wzy810103882/Vacant-Seat-Detector-System/Capstone Resource/CC3200 PCB/Headerboard concept.JPG

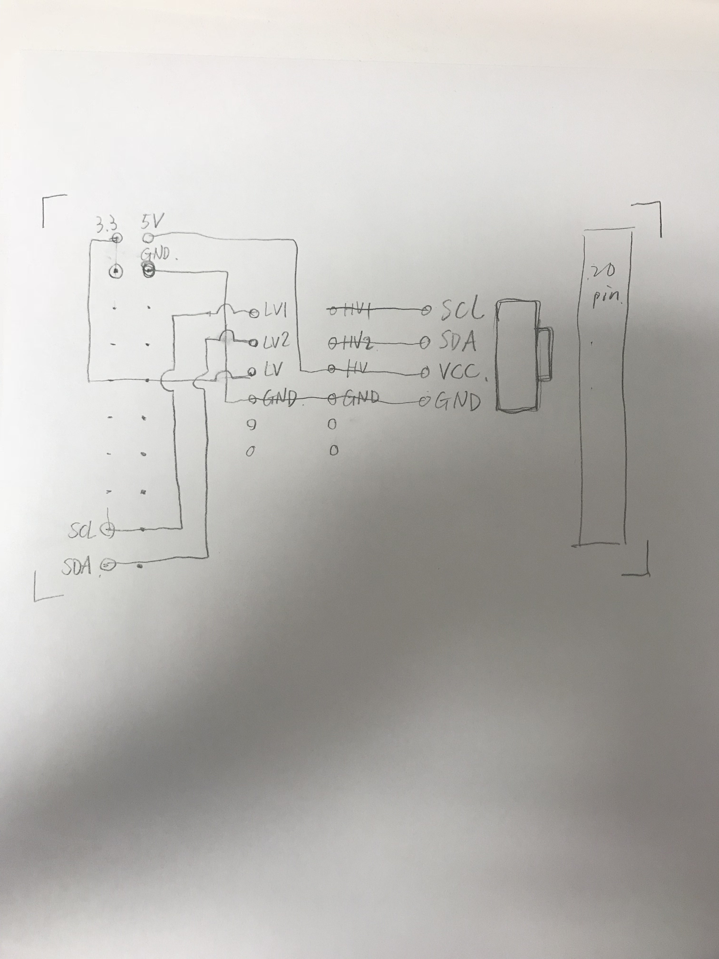
Capstone Resource/CC3200 PCB/Headerboard concept.JPG
