wzy810103882/Vacant-Seat-Detector-System/Capstone Resource/INFO/Screen Shot 2017-11-08 at 17.58.53.png

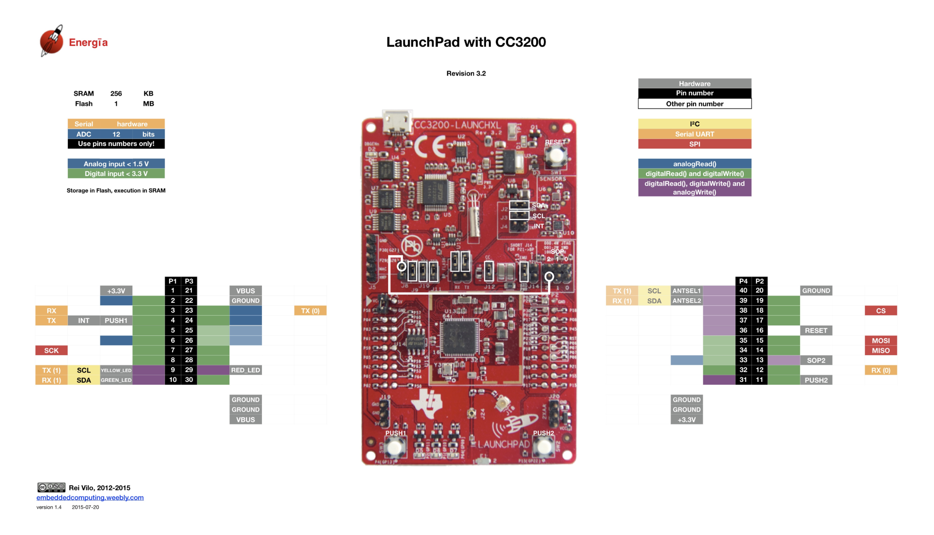
Capstone Resource/INFO/Screen Shot 2017-11-08 at 17.58.53.png
