wzy810103882/Vacant-Seat-Detector-System/Readme.txt

Track changes were turned after exporting from Google Doc
