wzy810103882/Vacant-Seat-Detector-System/Capstone Resource/CC3200 headerboard first sendout/s1.pdf

Job:0026870504903523+dfm.fdfm732002 Step:quote Layer:s1

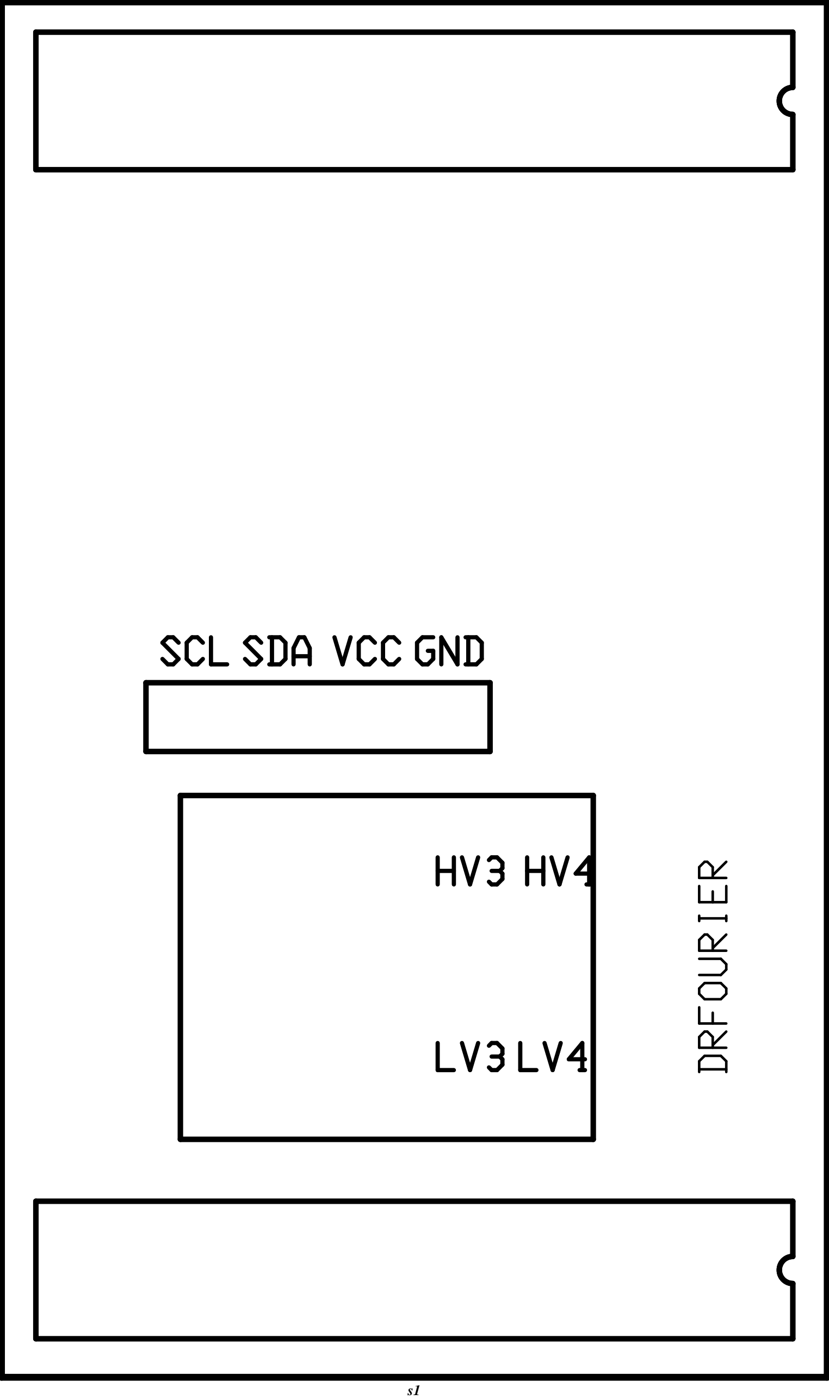
[picture p30: figure]
