wzy810103882/Vacant-Seat-Detector-System/Capstone Resource/cc3200 dimension.png

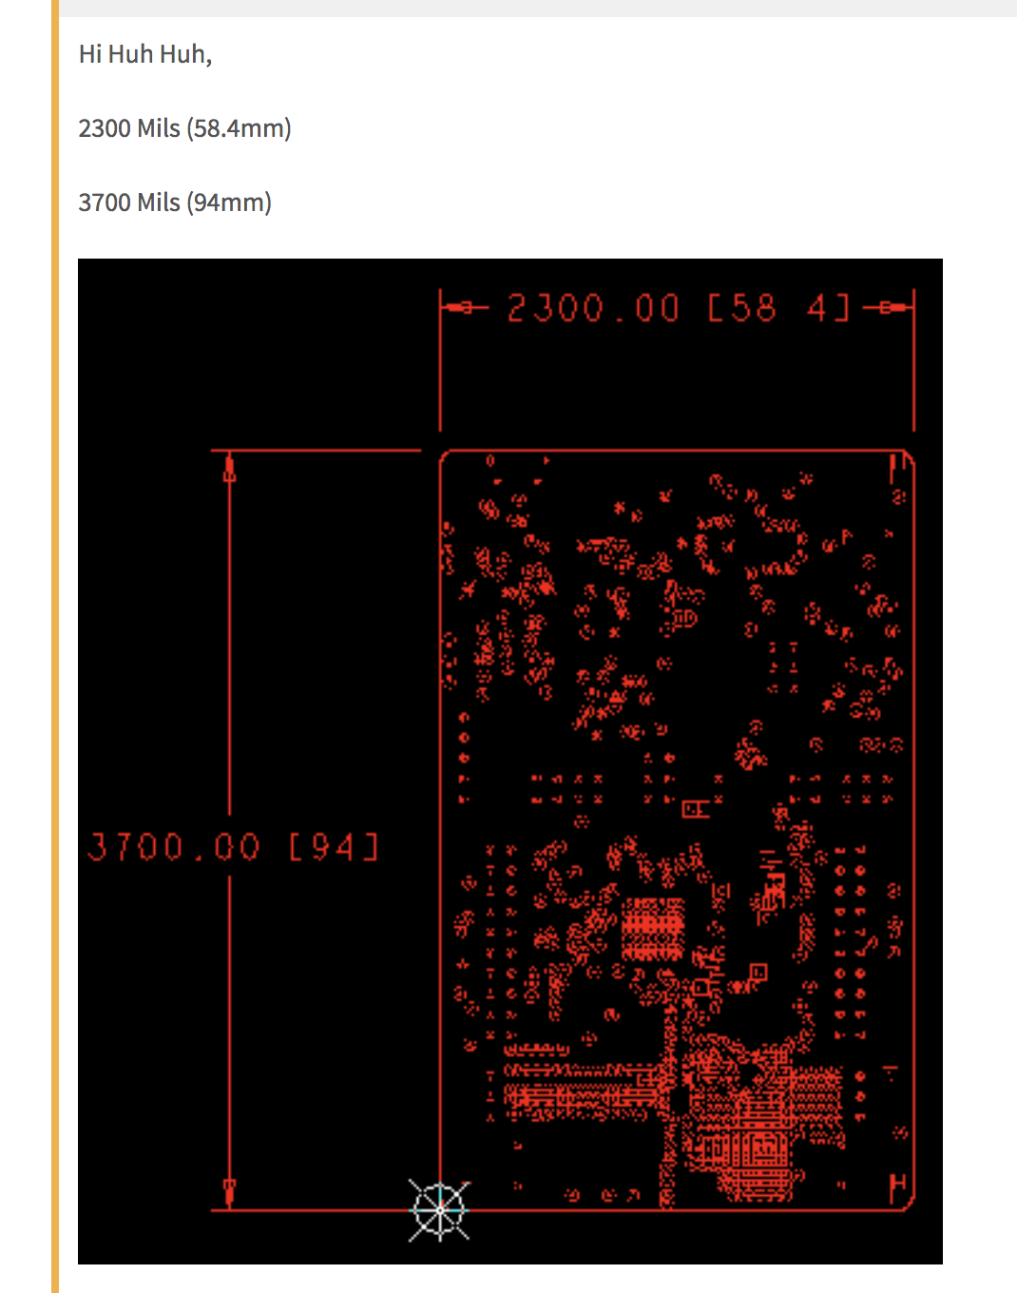
Capstone Resource/cc3200 dimension.png
