wzy810103882/Vacant-Seat-Detector-System/Capstone Resource/INFO/Screen Shot 2017-11-08 at 10.18.11.png

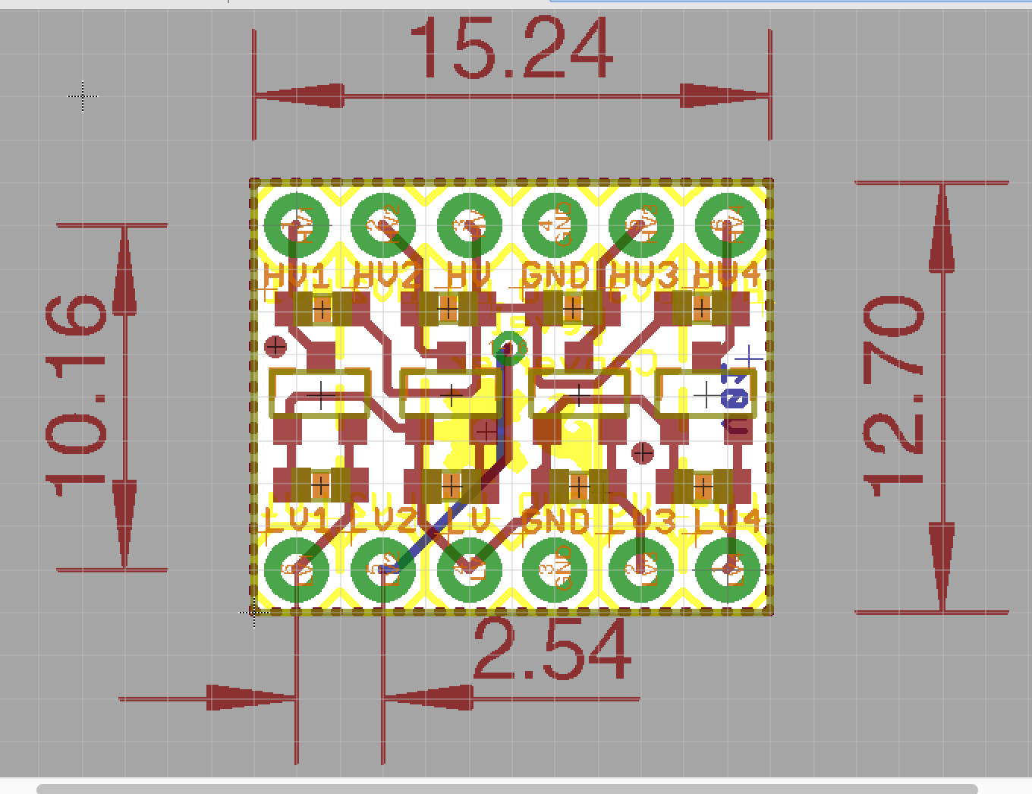
Capstone Resource/INFO/Screen Shot 2017-11-08 at 10.18.11.png
