wzy810103882/Vacant-Seat-Detector-System/Capstone Resource/INFO/Screen Shot 2017-11-10 at 10.47.15.png

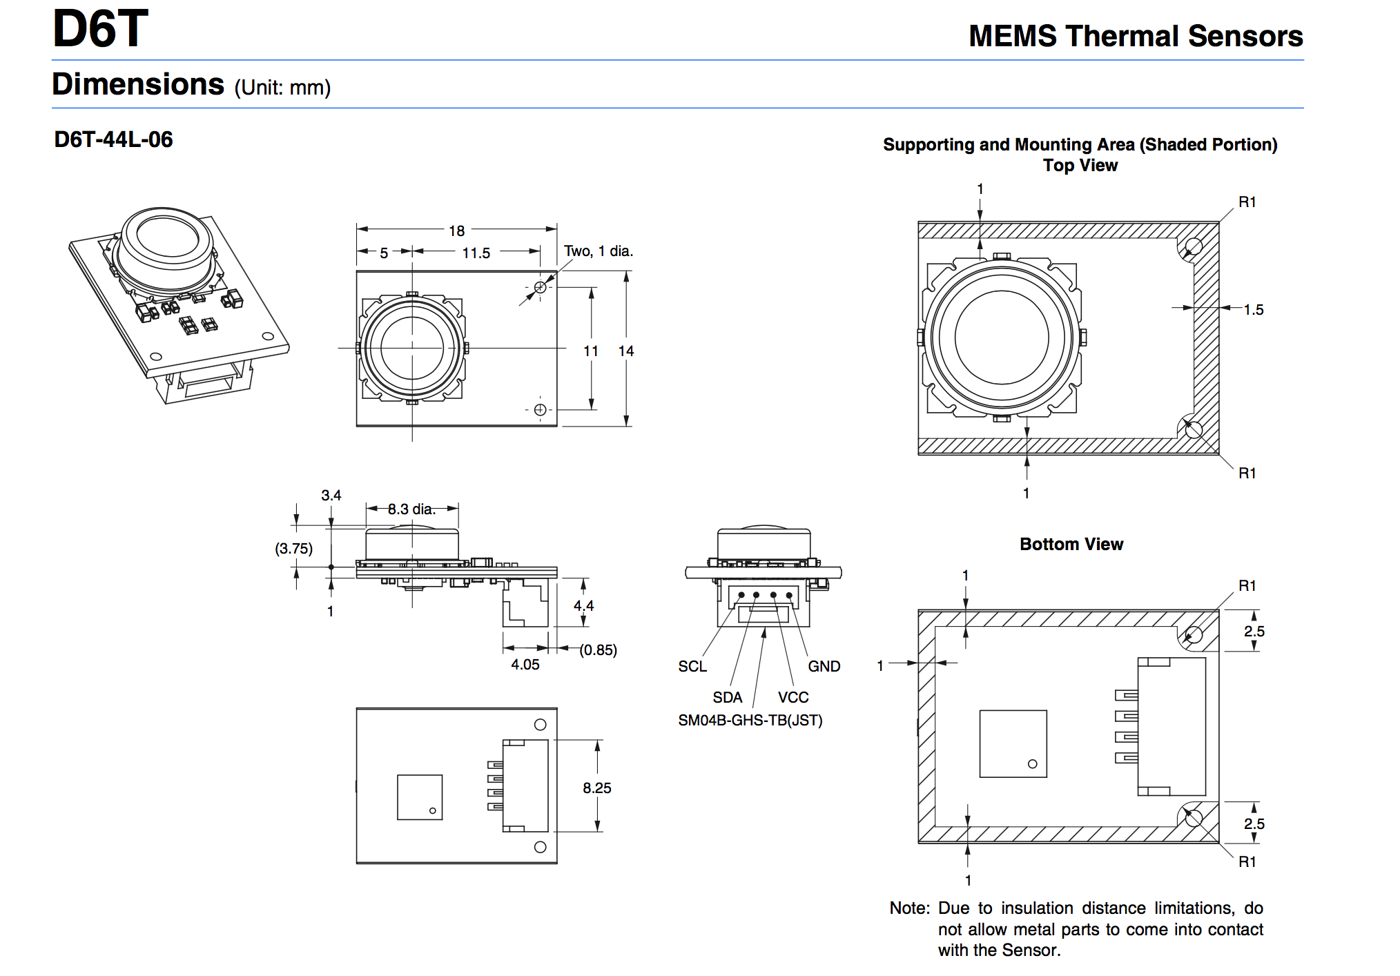
Capstone Resource/INFO/Screen Shot 2017-11-10 at 10.47.15.png
