wzy810103882/Vacant-Seat-Detector-System/Capstone Resource/Part Ordered/Dr. Fourier Parts.xlsx

 | Price per unit | number of units | total unit cost | part number | Link | Distributor | Datasheet
D6T Sensor | 52.5 | 1 | 52.5 | Z3637-ND | https://www.digikey.com/product-detail/en/omron-electronics-inc-emc-div/D6T44L06/Z3637-ND/3671589 | Digikey | From link
CC3100 Module | 20.76 | 1 | 20.76 | 296-37769-ND | https://www.digikey.com/product-detail/en/texas-instruments/CC3100BOOST/296-37769-ND/4862810 | Digikey | From link
