wzy810103882/Vacant-Seat-Detector-System/Capstone Resource/Part Ordered/Dr. Fourier Parts2.xlsx

 | Price per unit | number of units | total unit cost | part number | Link | Distributor | Datasheet
2-Way Logic Shifter | 2.95 | 1 | 2.95 | 1568-1209-ND | https://www.digikey.com/scripts/DkSearch/dksus.dll?Detail&itemSeq=241314373&uq=636438559609488572 | Digikey | From link
