wzy810103882/Vacant-Seat-Detector-System/Capstone Resource/Part Ordered/Dr. Fourier Parts3.xlsx

 | Price per unit | number of units | total unit cost | part number | Link | Distributor | Datasheet
CONN HEADER FEM 20POS.1" DL GOLD | 1.26 | 4 | 5.04 | S6106-ND | https://www.digikey.com/products/en?mpart=PPPC102LFBN-RC&v=35 | Digikey | From link
