wzy810103882/Vacant-Seat-Detector-System/Capstone Resource/final cad/beam.stl

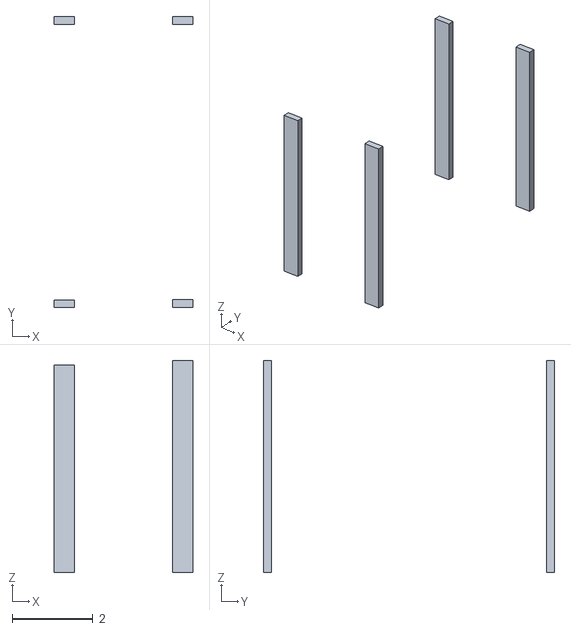
[picture p36: CAD file, 2018-04-12]
Capstone Resource/final cad/beam.stl
3.43 x 7.21 x 5.25
