wzy810103882/Vacant-Seat-Detector-System/Capstone Resource/Case/beam_2.stl

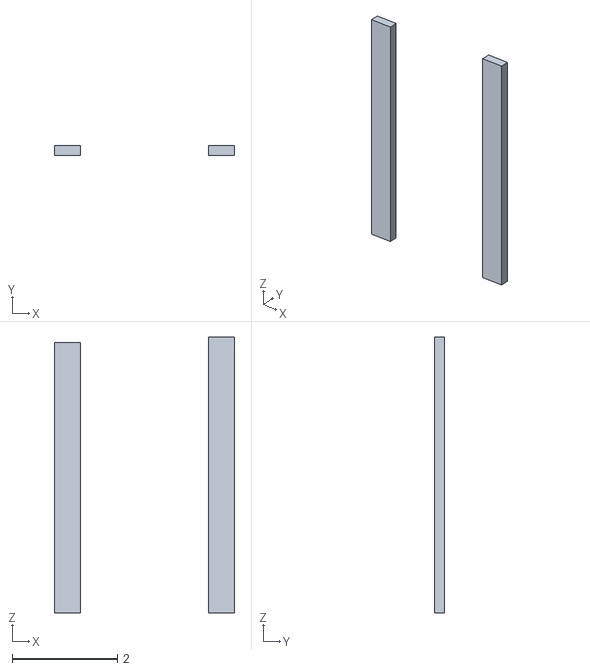
[picture p37: CAD file, 2018-04-12]
Capstone Resource/Case/beam_2.stl
3.43 x 0.198 x 5.25
