wzy810103882/Vacant-Seat-Detector-System/Capstone Resource/Case1/case_small_cubepro.stl

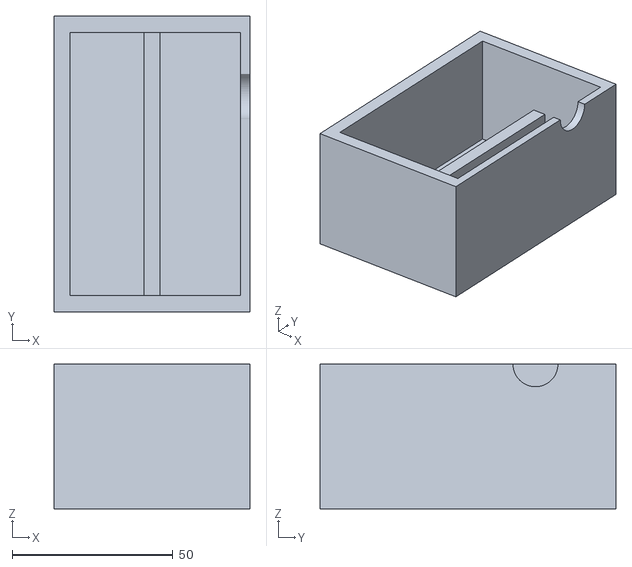
[picture p38: CAD file, 2018-04-12]
Capstone Resource/Case1/case_small_cubepro.stl
61.0 x 92.0 x 45.0
