wzy810103882/Vacant-Seat-Detector-System/Capstone Resource/final cad/Case_small_slot.stl

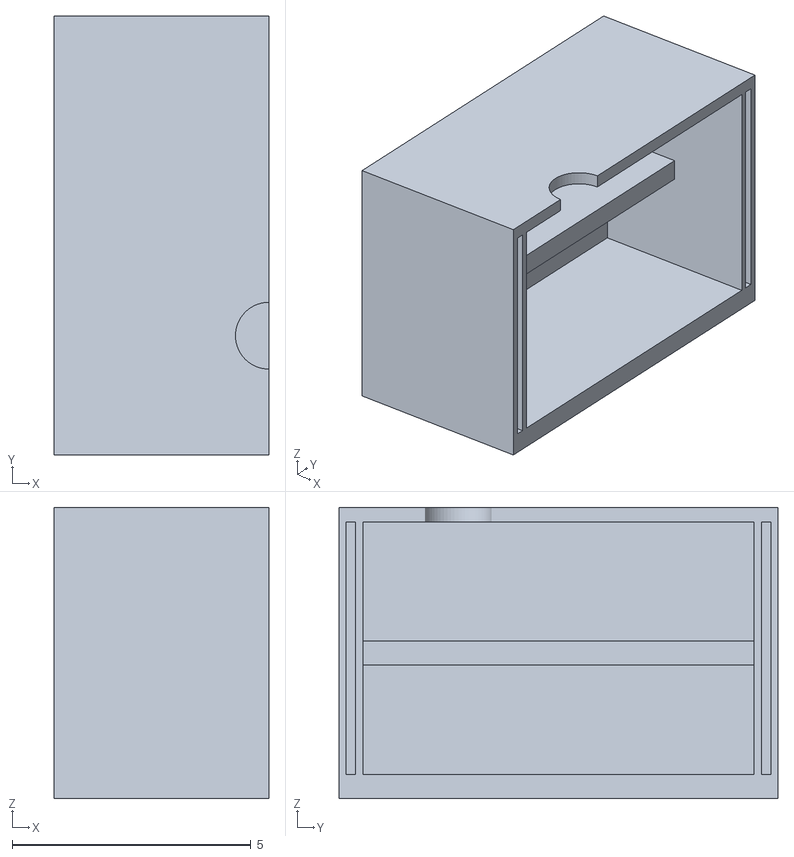
[picture p39: CAD file, 2018-04-12]
Capstone Resource/final cad/Case_small_slot.stl
4.50 x 9.20 x 6.10
