wzy810103882/Vacant-Seat-Detector-System/Capstone Resource/Case/Capstone Case.stl

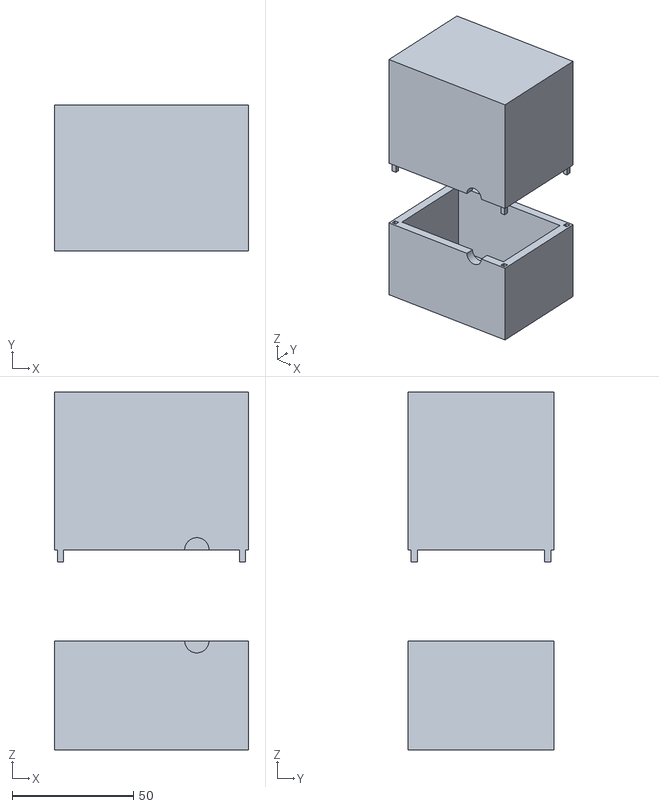
[picture p40: CAD file, 2018-04-12]
Capstone Resource/Case/Capstone Case.stl
80.0 x 60.0 x 147.5
