wzy810103882/Vacant-Seat-Detector-System/Capstone Resource/Case1/case_small.stl

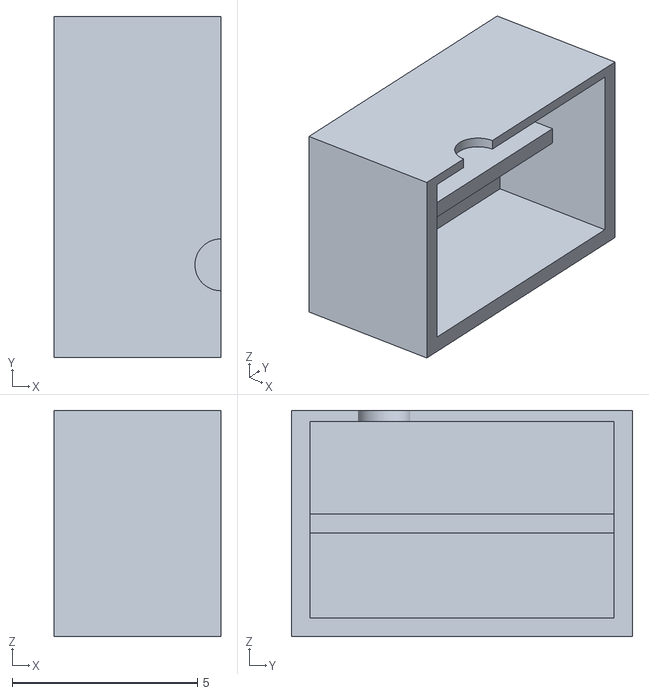
[picture p41: CAD file, 2018-04-12]
Capstone Resource/Case1/case_small.stl
4.50 x 9.20 x 6.10
