wzy810103882/Vacant-Seat-Detector-System/Capstone Resource/final cad/Case_large.stl

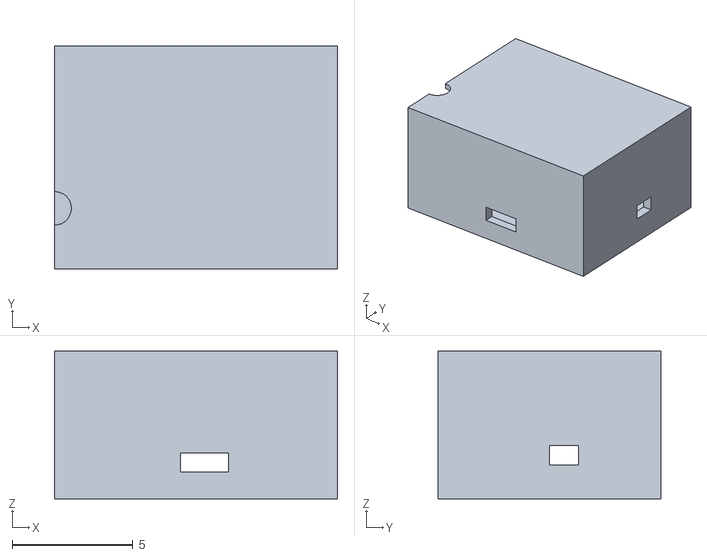
[picture p42: CAD file, 2018-04-12]
Capstone Resource/final cad/Case_large.stl
11.7 x 9.20 x 6.10
