wzy810103882/Vacant-Seat-Detector-System/Capstone Resource/Case1/Case_forprint.stl

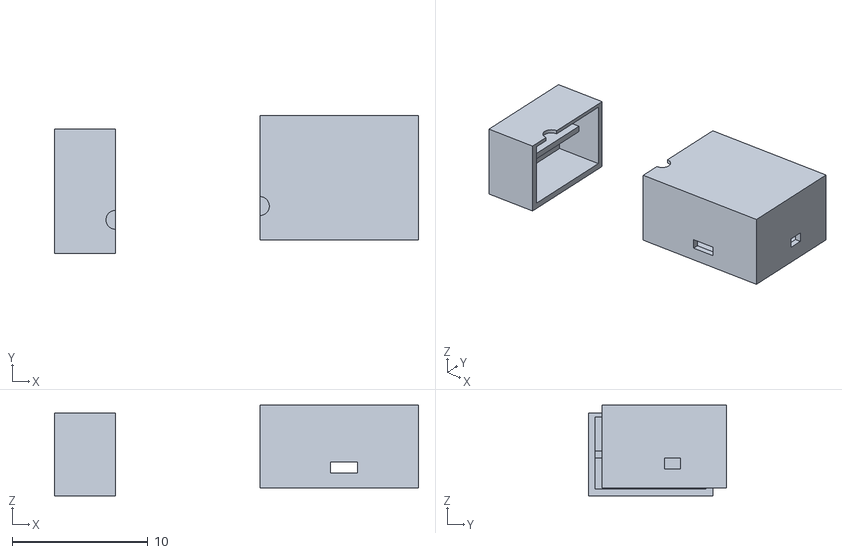
[picture p43: CAD file, 2018-04-12]
Capstone Resource/Case1/Case_forprint.stl
26.8 x 10.2 x 6.68
