wzy810103882/Vacant-Seat-Detector-System/Capstone Resource/Case1/Case_v3.stl

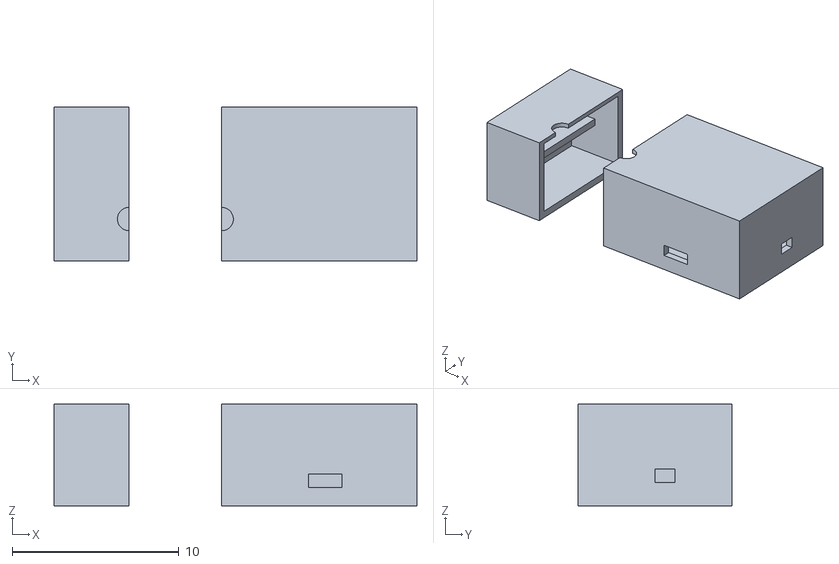
[picture p44: CAD file, 2018-04-12]
Capstone Resource/Case1/Case_v3.stl
21.7 x 9.20 x 6.10
