wzy810103882/Vacant-Seat-Detector-System/(list of files, cad)

Other CAD files:
Capstone Resource/Case/case.dwg
Capstone Resource/Case/beam_1.stl
Capstone Resource/Case1/3dcase.dwg
Capstone Resource/Case1/Case 3d print.dwg
Capstone Resource/Case/Capstone Case.3dm
Capstone Resource/Case1/case_large_fixed.3dm
