wzy810103882/Vacant-Seat-Detector-System/Capstone Resource/CC3200 headerboard first sendout/drp.pdf

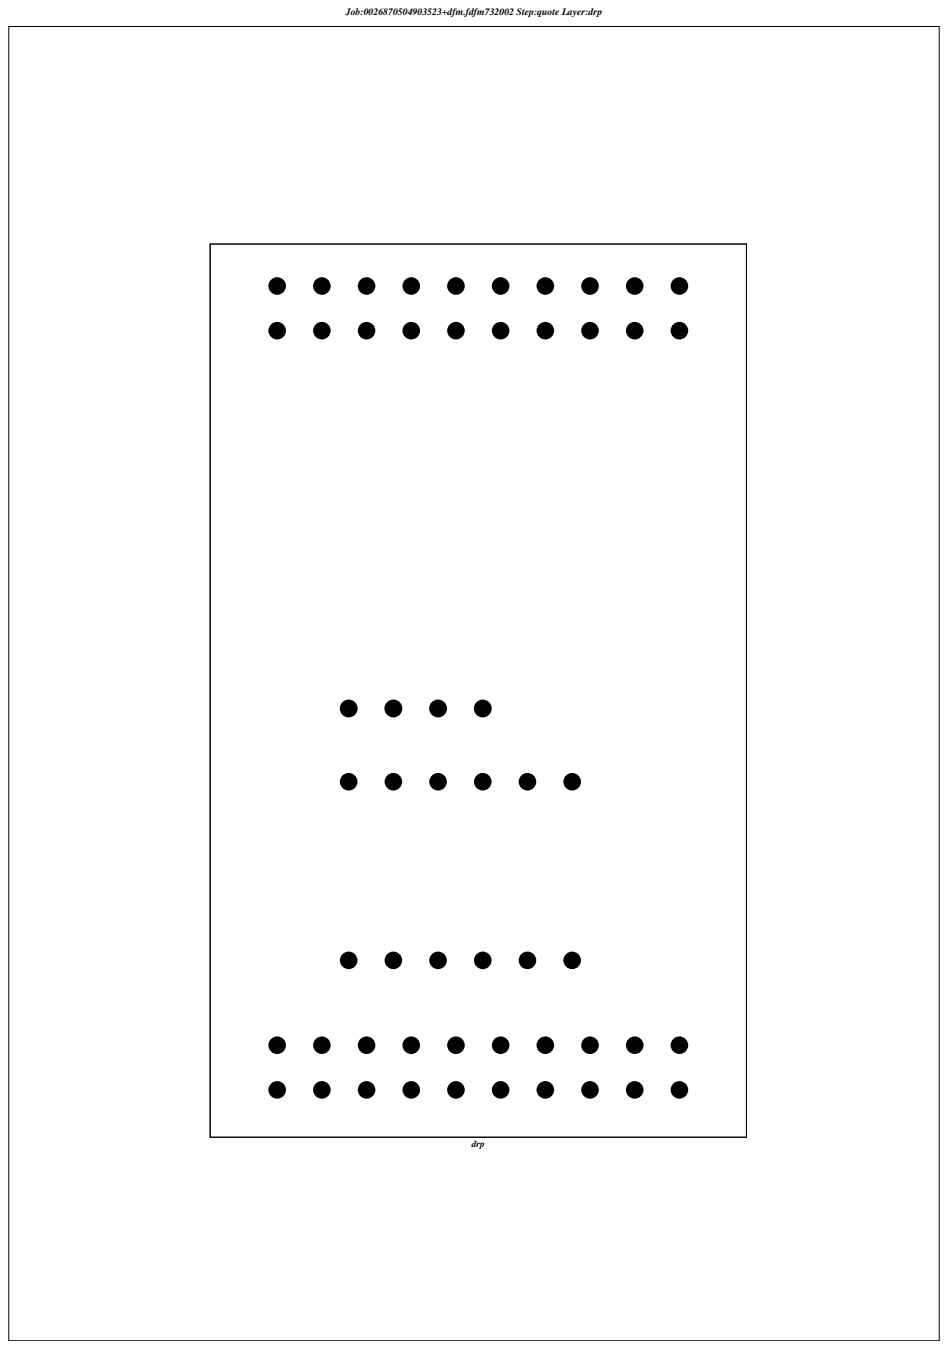
[picture p47: page 1]
drp

Job:0026870504903523+dfm.fdfm732002 Step:quote Layer:drp
