wzy810103882/Vacant-Seat-Detector-System/Capstone Resource/CC3200 headerboard first sendout/l1.pdf

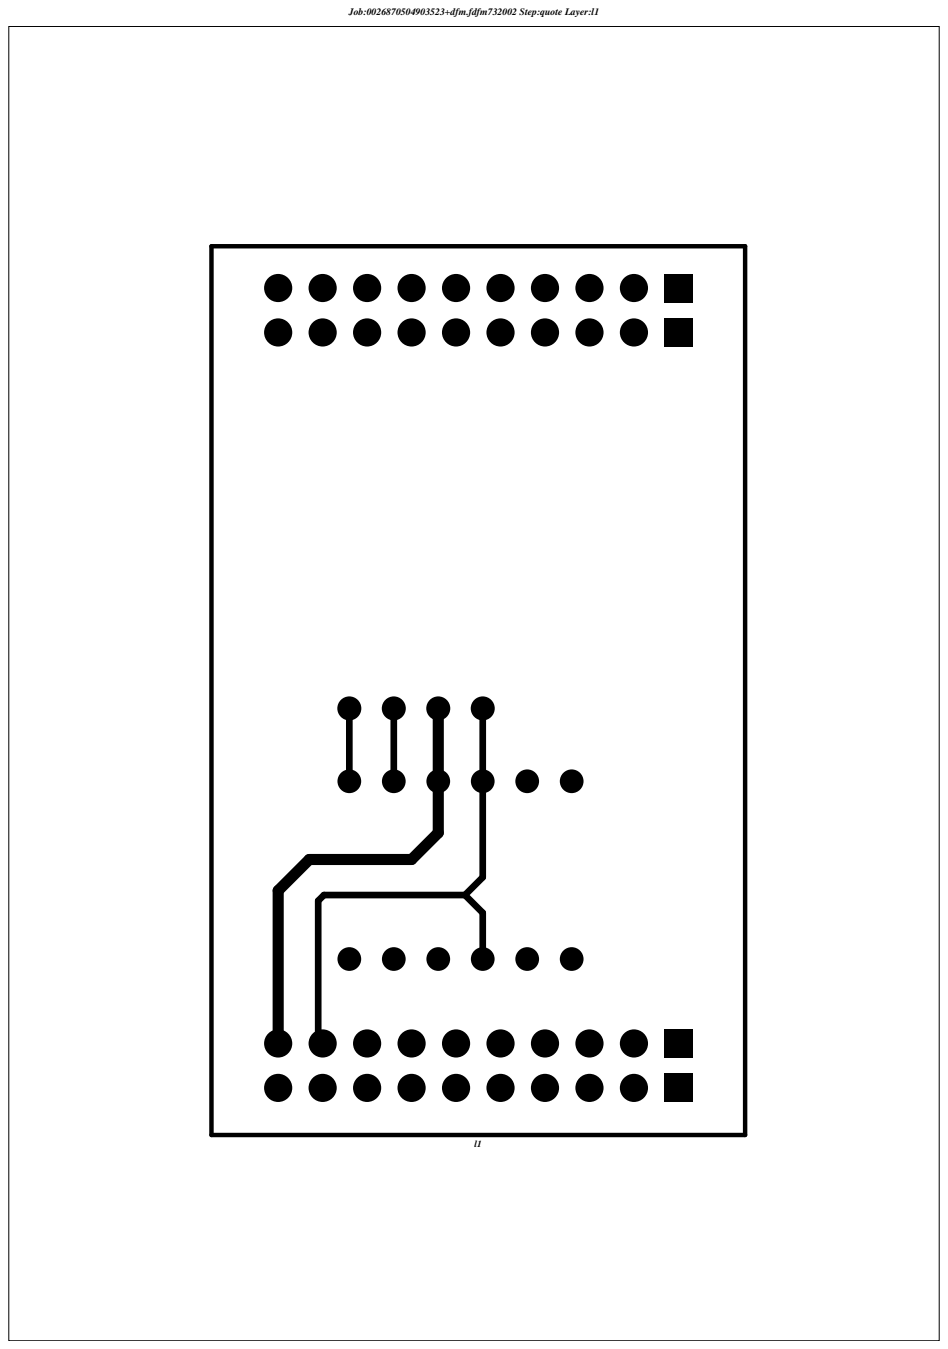
[picture p48: page 1]

Job:0026870504903523+dfm.fdfm732002 Step:quote Layer:l1
