wzy810103882/Vacant-Seat-Detector-System/Capstone Resource/CC3200 headerboard first sendout/m2.pdf

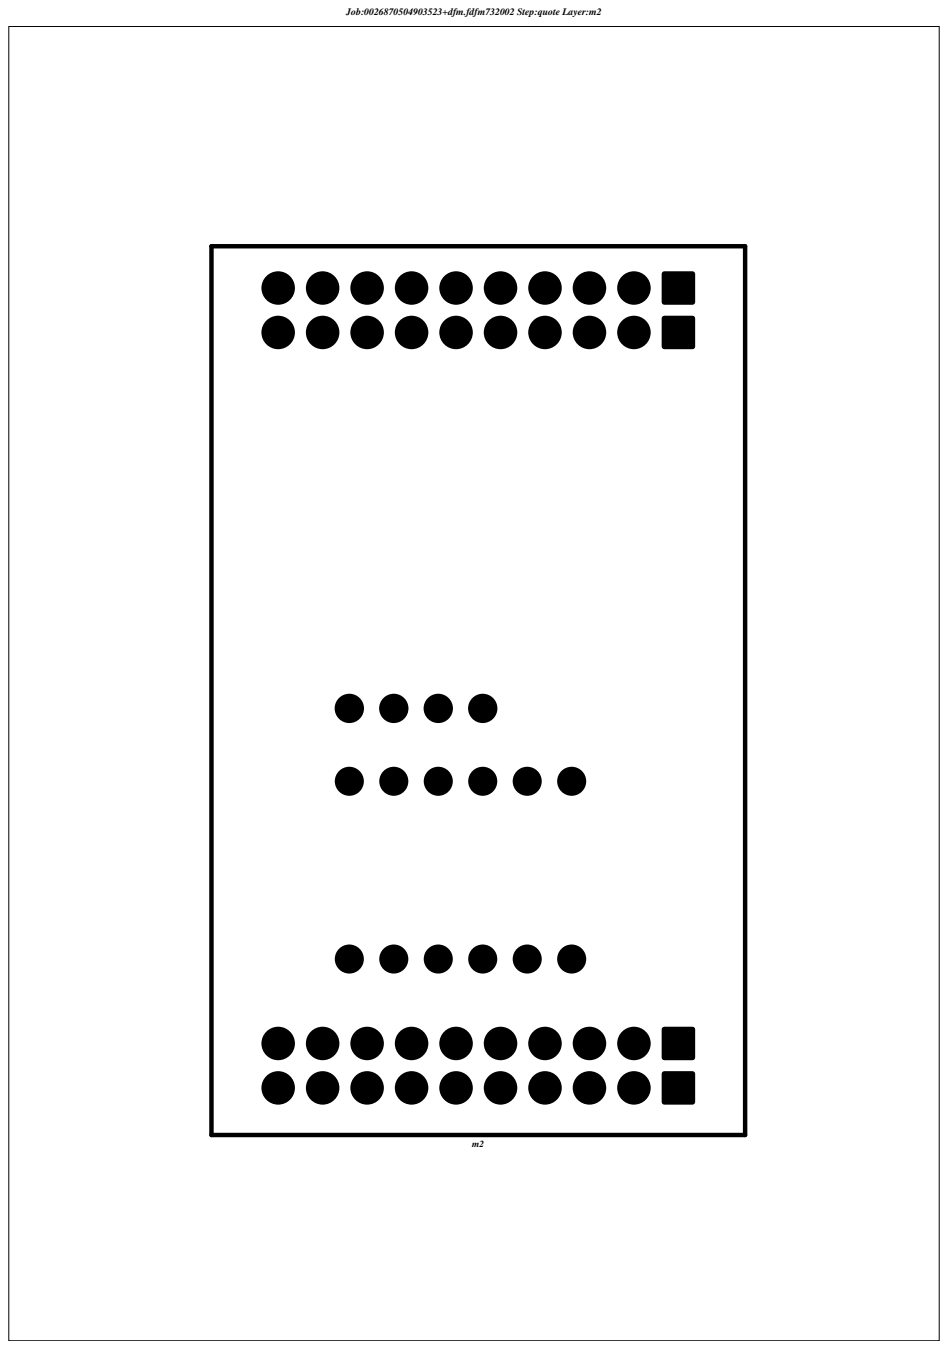
[picture p51: page 1]

Job:0026870504903523+dfm.fdfm732002 Step:quote Layer:m2
