wzy810103882/Vacant-Seat-Detector-System/(list of files, drawings)

Other design files:
Capstone Resource/cc3200 gerber/CC3200-LAUNCHXL_SCH_REV4P1-C.DSN
Capstone Resource/cc3200 gerber/CC3200-LAUNCHXL_SCH_REV4P1-C.opj
Capstone Resource/CC3200 PCB/cc3200 headerboard/Bidirec Logic Converter.ms14
Capstone Resource/CC3200 PCB/cc3200 headerboard/cc3200 Headerboard.ms14
Capstone Resource/CC3200 PCB/cc3200 headerboard/D6T.ms14
