wzy810103882/Vacant-Seat-Detector-System/Capstone Resource/Case1/CC3200 test code/ConnectNoEncryption/ConnectNoEncryption.ino

/*

 This example connects to an unencrypted Wifi network.
 Then it prints the MAC address of the Wifi BoosterPack / LaunchPad,
 the IP address obtained, and other network details.

 Circuit:
 * CC3200 WiFi LaunchPad or CC3100 WiFi BoosterPack
   with TM4C or MSP430 LaunchPad

 created 13 July 2010
 by dlf (Metodo2 srl)
 modified 31 May 2012
 by Tom Igoe
 modified 2 July 2014
 by Noah Luskey
 */

#ifndef __CC3200R1M1RGC__
// Do not include SPI for CC3200 LaunchPad
//#include <SPI.h>
#endif
#include <WiFi.h>
#include <WiFiClient.h>

// your network name also called SSID
char ssid[] = "wahoo";

void setup() {
  //Initialize serial and wait for port to open:
  Serial.begin(115200);

  // attempt to connect to Wifi network:
  Serial.print("Attempting to connect to Network named: ");
  // print the network name (SSID);
  Serial.println(ssid); 
  // Connect to WPA/WPA2 network. Change this line if using open or WEP network:
  WiFi.begin(ssid);
  while ( WiFi.status() != WL_CONNECTED) {
    // print dots while we wait to connect
    Serial.print(".");
    delay(300);
  }
  
  Serial.println("\nYou're connected to the network");
  Serial.println("Waiting for an ip address");
  
  while (WiFi.localIP() == INADDR_NONE) {
    // print dots while we wait for an ip addresss
    Serial.print(".");
    delay(300);
  }

  Serial.println("\nIP Address obtained");
  
  // you're connected now, so print out the status  
  printCurrentNet();
  printWifiData();
}

void loop() {
  // check the network connection once every 10 seconds:
  delay(10000);
  printCurrentNet();
}

void printWifiData() {
  // print your WiFi IP address:
  IPAddress ip = WiFi.localIP();
  Serial.print("IP Address: ");
  Serial.println(ip);
  Serial.println(ip);

  // print your MAC address:
  byte mac[6];
  WiFi.macAddress(mac);
  Serial.print("MAC address: ");
  Serial.print(mac[5], HEX);
  Serial.print(":");
  Serial.print(mac[4], HEX);
  Serial.print(":");
  Serial.print(mac[3], HEX);
  Serial.print(":");
  Serial.print(mac[2], HEX);
  Serial.print(":");
  Serial.print(mac[1], HEX);
  Serial.print(":");
  Serial.println(mac[0], HEX);

  // print your subnet mask:
  IPAddress subnet = WiFi.subnetMask();
  Serial.print("NetMask: ");
  Serial.println(subnet);

  // print your gateway address:
  IPAddress gateway = WiFi.gatewayIP();
  Serial.print("Gateway: ");
  Serial.println(gateway);
}

void printCurrentNet() {
  // print the SSID of the network you're attached to:
  Serial.print("SSID: ");
  Serial.println(WiFi.SSID());

  // print the MAC address of the router you're attached to:
  byte bssid[6];
  WiFi.BSSID(bssid);
  Serial.print("BSSID: ");
  Serial.print(bssid[5], HEX);
  Serial.print(":");
  Serial.print(bssid[4], HEX);
  Serial.print(":");
  Serial.print(bssid[3], HEX);
  Serial.print(":");
  Serial.print(bssid[2], HEX);
  Serial.print(":");
  Serial.print(bssid[1], HEX);
  Serial.print(":");
  Serial.println(bssid[0], HEX);

  // print the received signal strength:
  long rssi = WiFi.RSSI();
  Serial.print("signal strength (RSSI):");
  Serial.println(rssi);

  // print the encryption type:
  byte encryption = WiFi.encryptionType();
  Serial.print("Encryption Type:");
  Serial.println(encryption, HEX);
}
